Jarx12/YRS_ST7789/Docs/SH FOR BLUE THERMISTOR CAR 110C.png

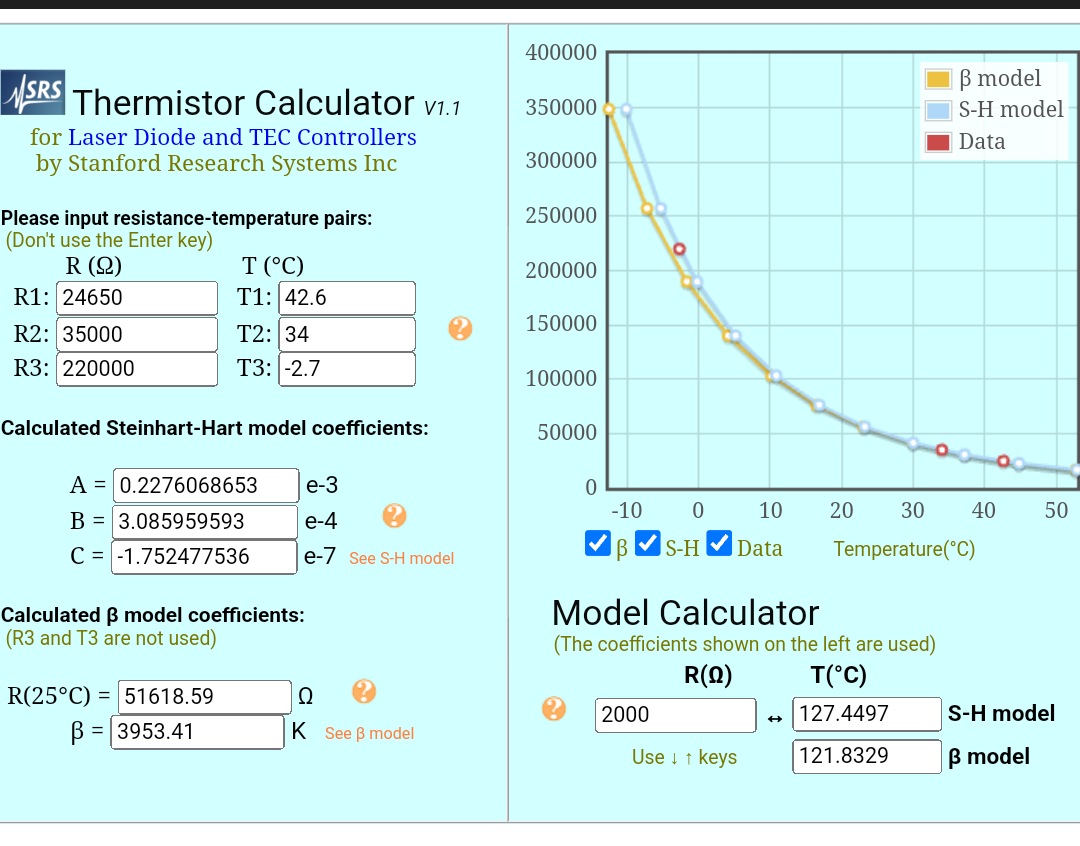
Docs/SH FOR BLUE THERMISTOR CAR 110C.png
