Jarx12/YRS_ST7789/Docs/SH FOR HW503.JPG

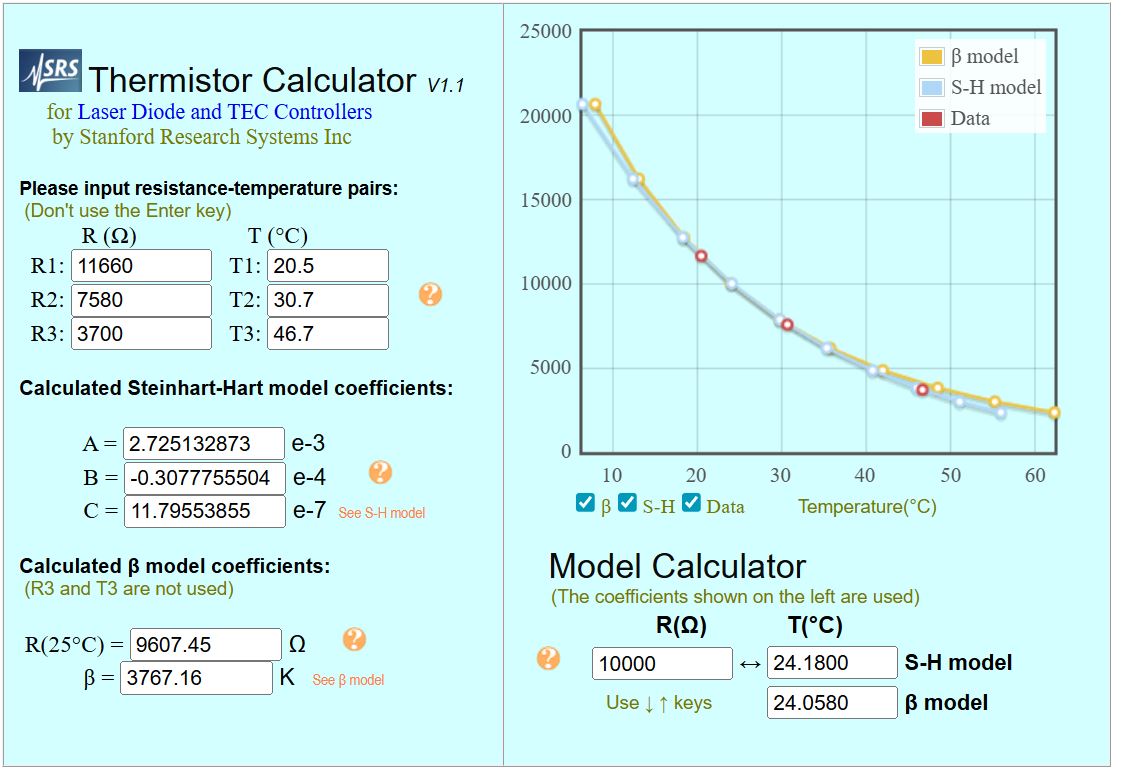
Docs/SH FOR HW503.JPG
