Jarx12/YRS_ST7789/(commit log)

2026-06-11 Moved to digital low pass filter for engine and A/C temp
2026-07-22 UI refactor and fixes, added trend functionality and indicators for values
    [YRS_ST7789.ino]
2026-07-22 Increase buffer size for trend tracking and adjust display delays and colors for better visibility, fixed AC Trend not getting properly instantiated
    [YRS_ST7789.ino]
2026-09-26 Refactor project structure: remove redundant README files, update platformio.ini for proper backlight pin, and enhance YRS_ST7789.ino with better trend tracking and alert features.
2026-09-28 Removed trend tracker class and references added a proper plot graphic with user button input support, refactored thermistor readings into a single class
2026-10-24 Adjust SPI frequency for noise mitigation add watchdog timer initialization and configuration for WiFi
